sotarokashiuchi/prototype-lesson/docs/picture_hardware/サーボモータ固定.jpg

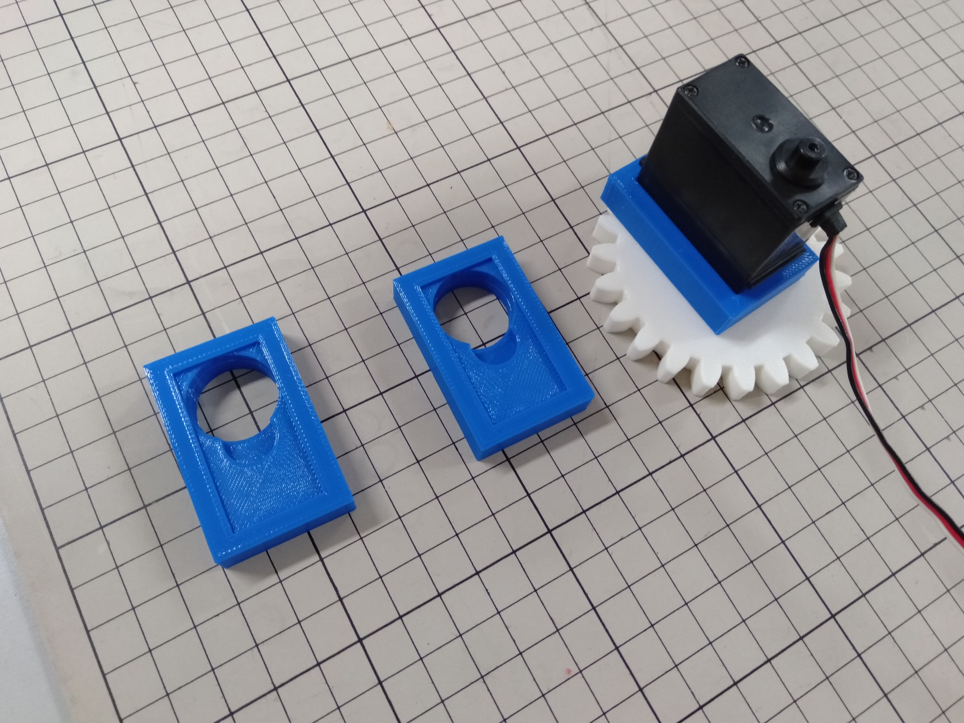
docs/picture_hardware/サーボモータ固定.jpg
