sotarokashiuchi/prototype-lesson/docs/picture_hardware/スクリーンショット 2025-07-04 091845.png

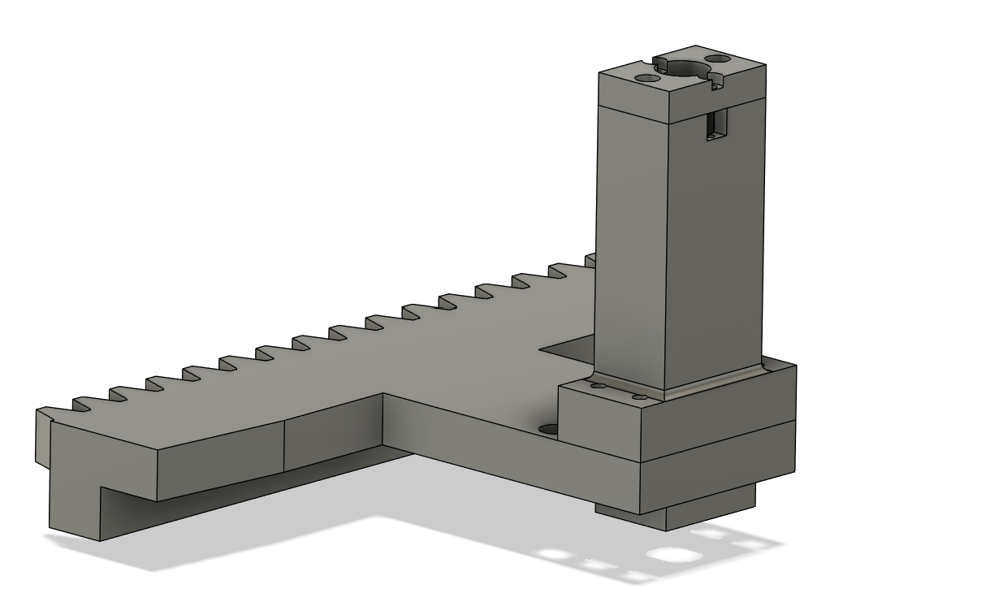
docs/picture_hardware/スクリーンショット 2025-07-04 091845.png
