sotarokashiuchi/prototype-lesson/docs/picture_hardware/スクリーンショット 2025-07-04 120317.png

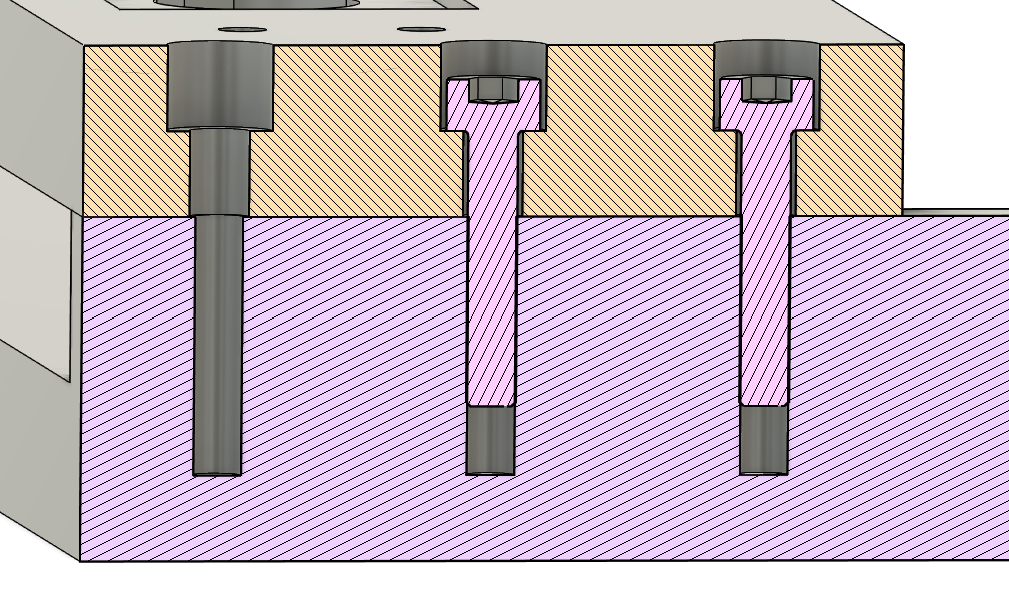
docs/picture_hardware/スクリーンショット 2025-07-04 120317.png
