sotarokashiuchi/prototype-lesson/docs/picture_hardware/スクリーンショット 2025-07-07 123605.png

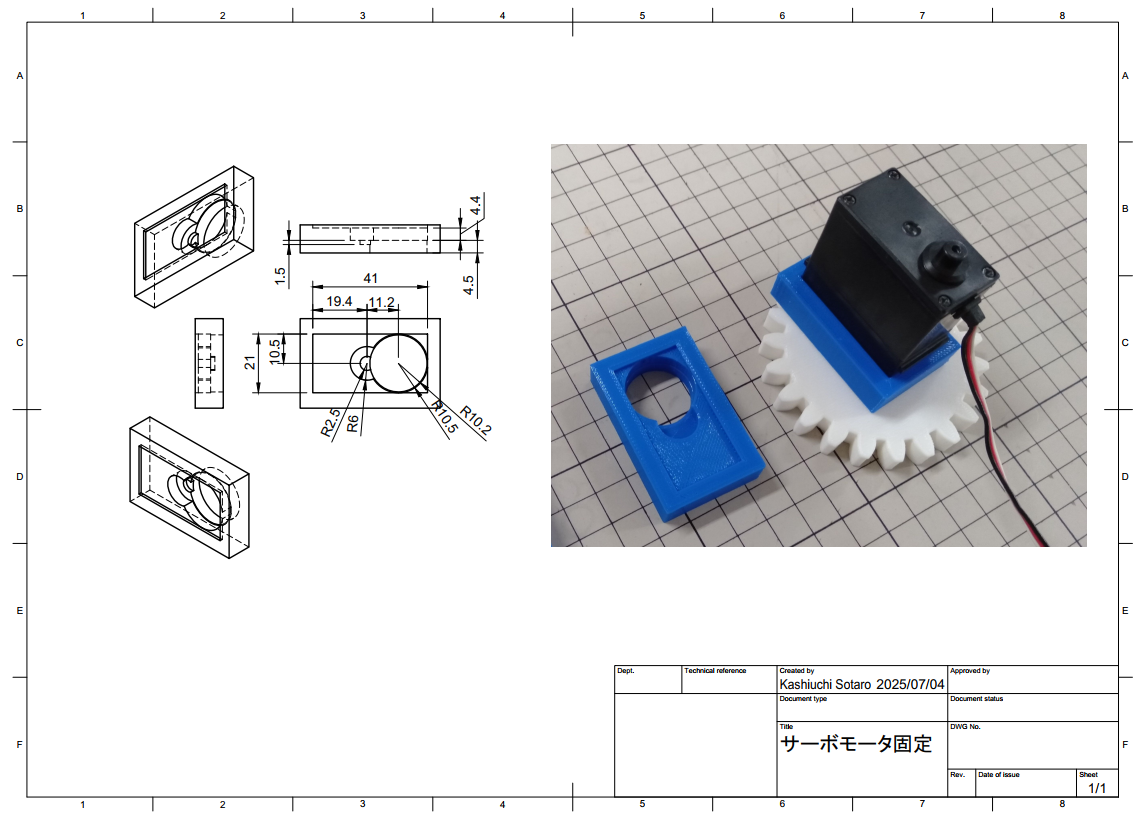
docs/picture_hardware/スクリーンショット 2025-07-07 123605.png
