sotarokashiuchi/prototype-lesson/docs/picture_hardware/スクリーンショット 2025-07-08 163721.png

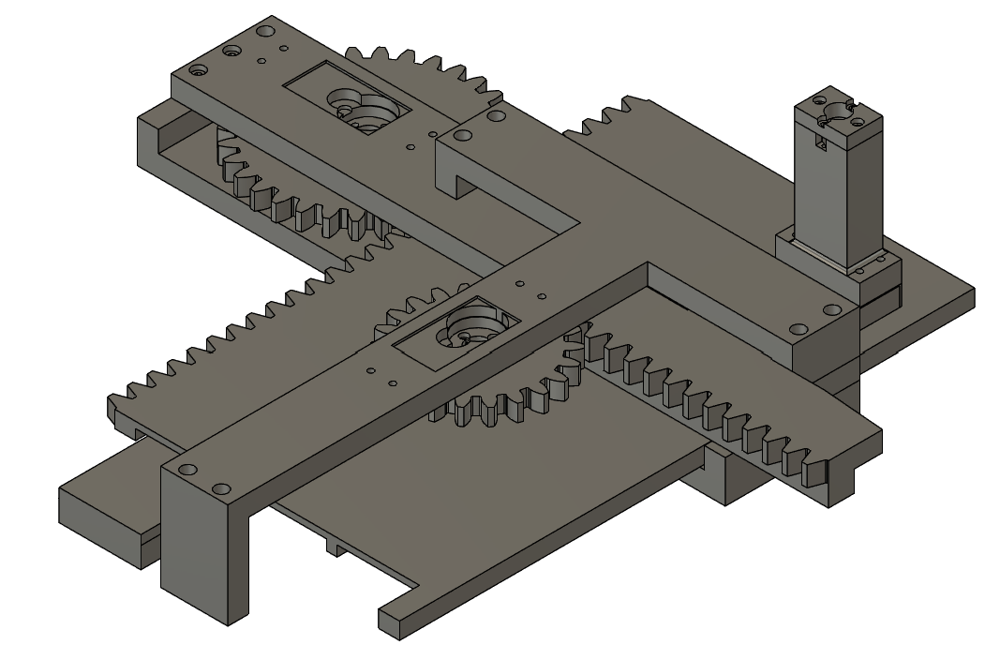
docs/picture_hardware/スクリーンショット 2025-07-08 163721.png
