sotarokashiuchi/prototype-lesson/docs/picture_hardware/スクリーンショット 2025-07-14 133244.png

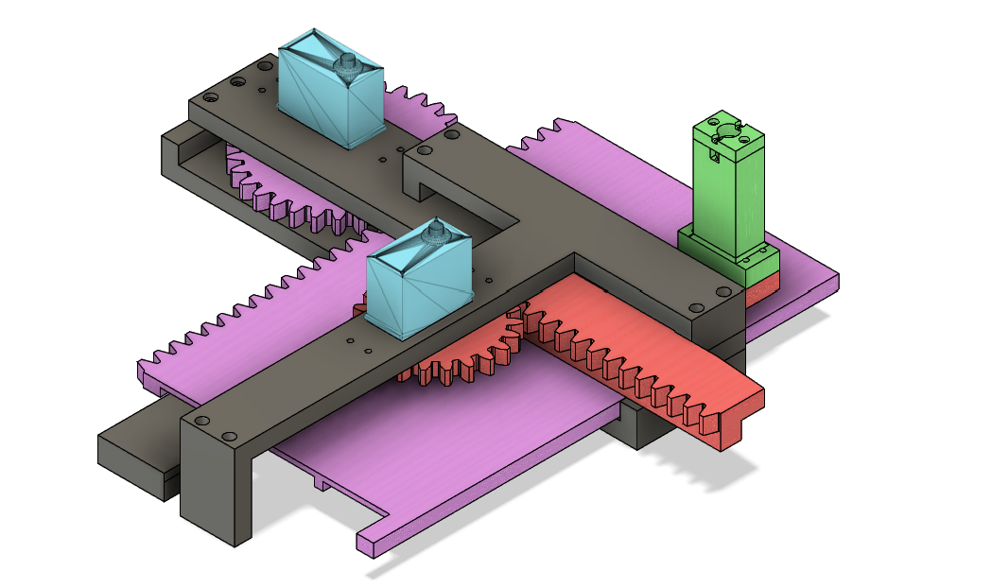
docs/picture_hardware/スクリーンショット 2025-07-14 133244.png
