sotarokashiuchi/prototype-lesson/docs/picture_hardware/ペン取り付け機3.jpg

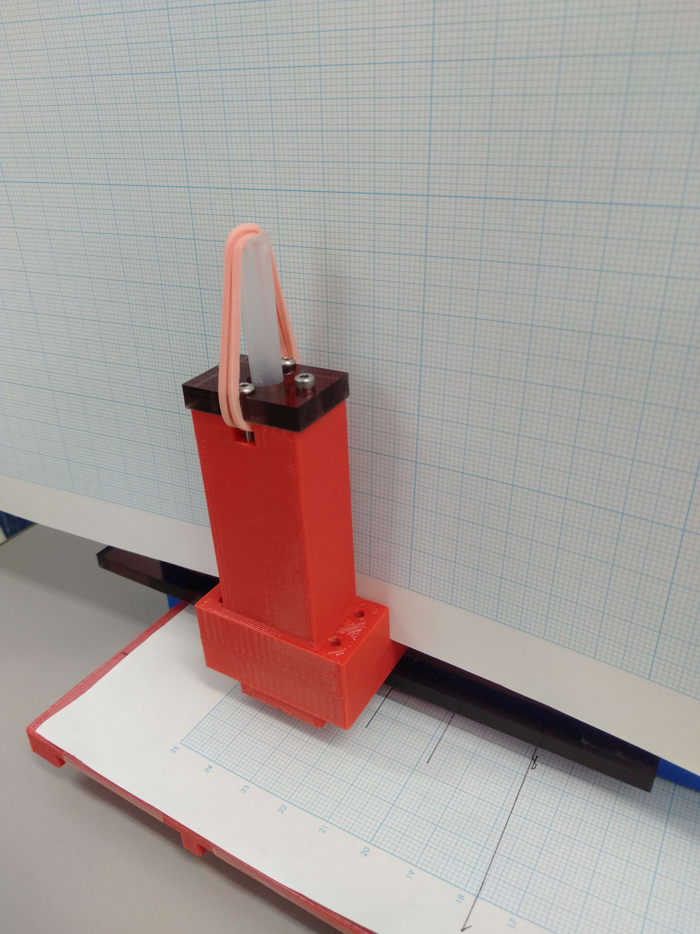
docs/picture_hardware/ペン取り付け機3.jpg
