sotarokashiuchi/prototype-lesson/docs/picture_hardware/ペン取り付け機構2.jpg

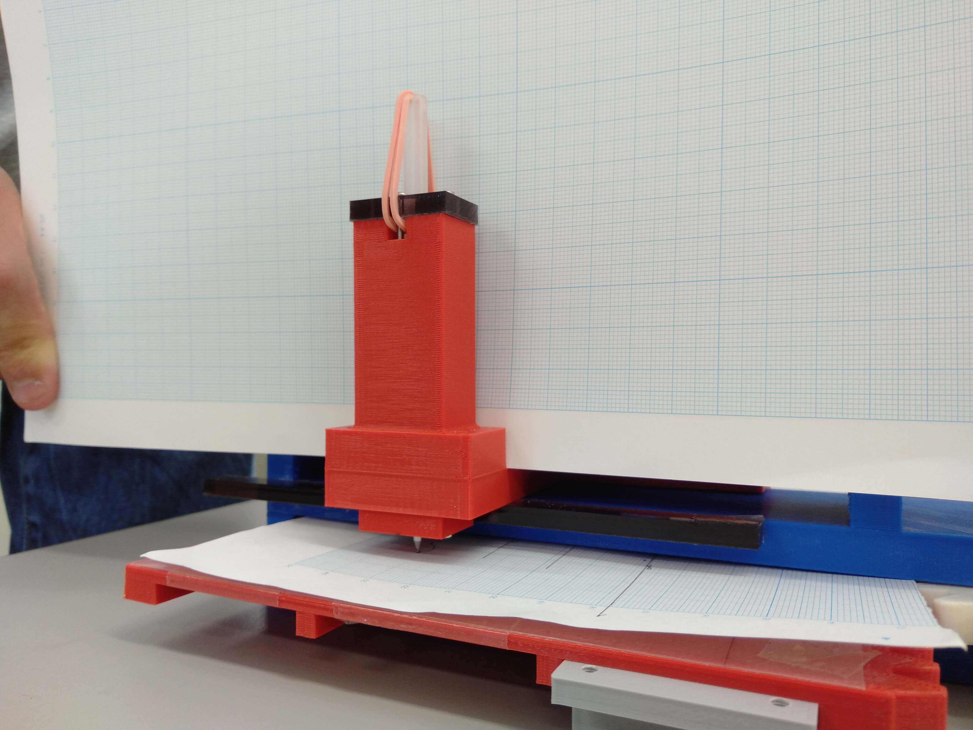
docs/picture_hardware/ペン取り付け機構2.jpg
