sotarokashiuchi/prototype-lesson/docs/picture_hardware/マシン本体1.jpg

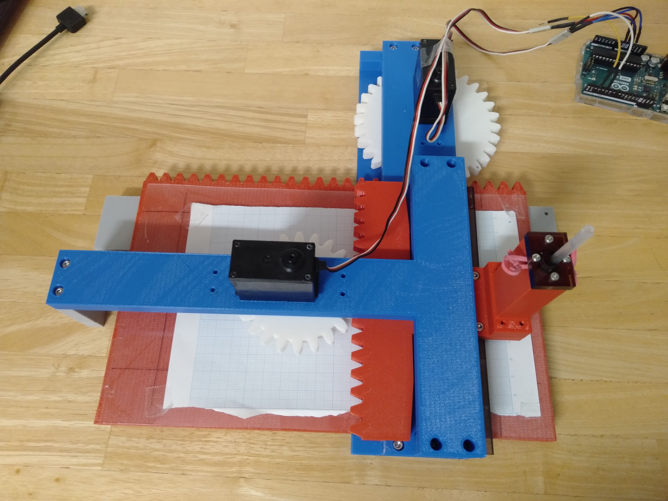
docs/picture_hardware/マシン本体1.jpg
