sotarokashiuchi/prototype-lesson/docs/picture_hardware/マシン本体3.jpg

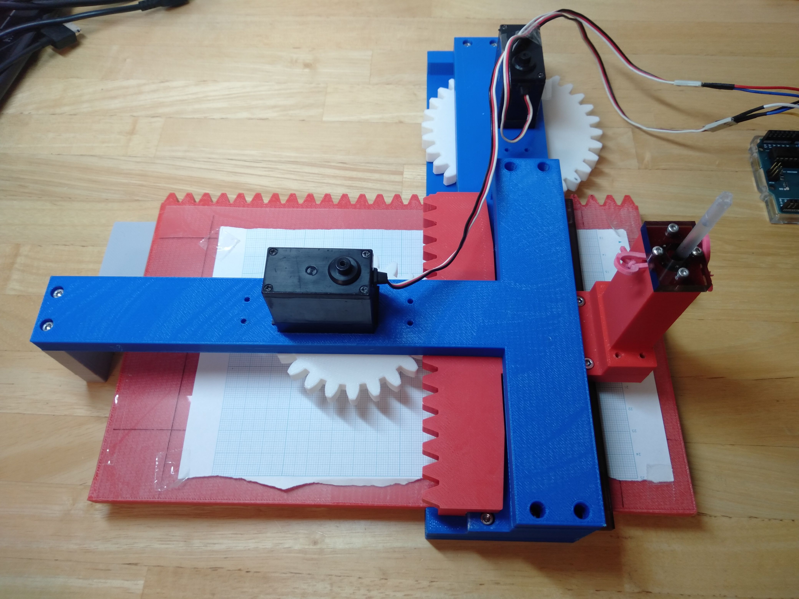
docs/picture_hardware/マシン本体3.jpg
