sotarokashiuchi/prototype-lesson/docs/picture_hardware/モータ精度測定1.jpg

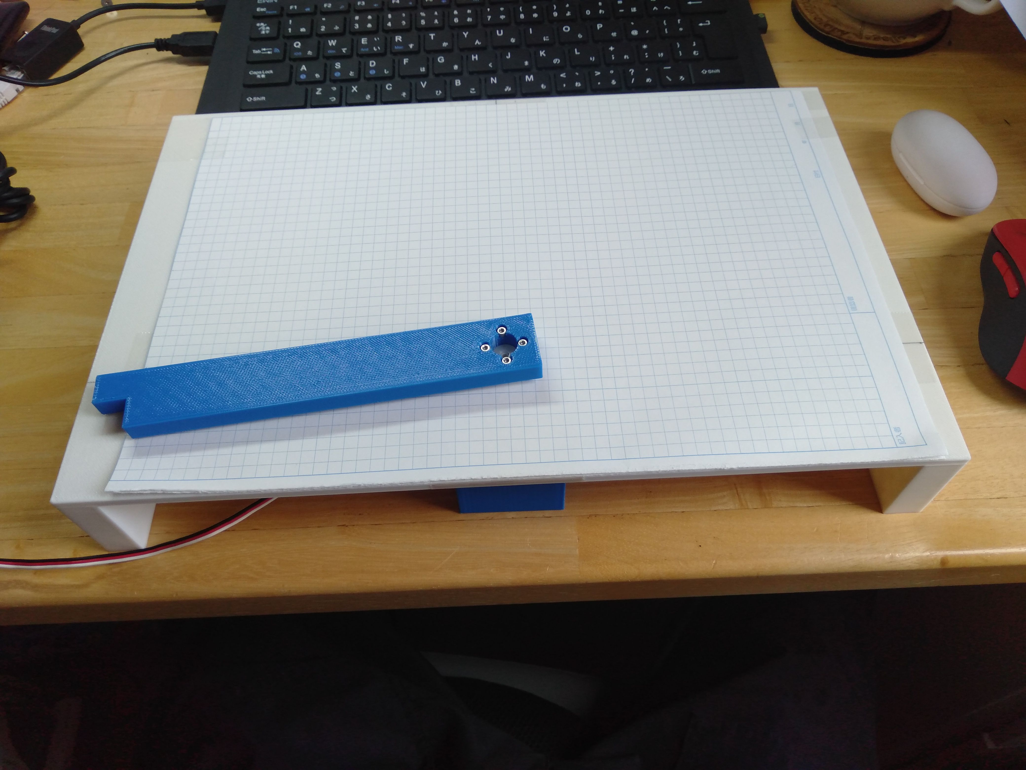
docs/picture_hardware/モータ精度測定1.jpg
