sotarokashiuchi/prototype-lesson/docs/picture_hardware/モータ精度測定2.jpg

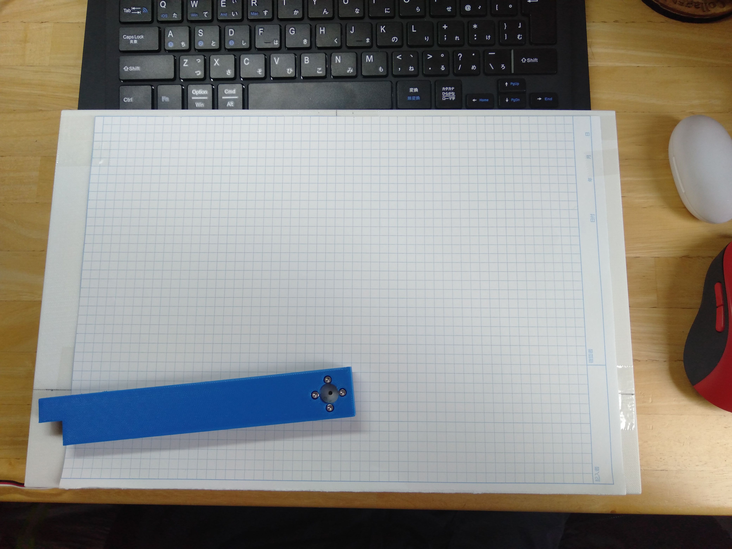
docs/picture_hardware/モータ精度測定2.jpg
