sotarokashiuchi/prototype-lesson/docs/picture_hardware/機構の選定1.png

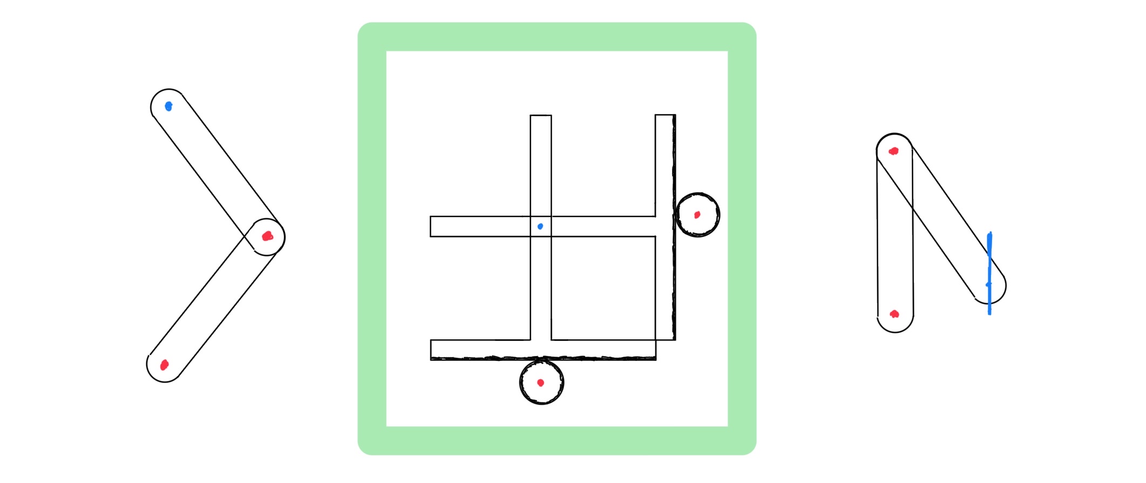
docs/picture_hardware/機構の選定1.png
