sotarokashiuchi/prototype-lesson/docs/picture_software/スクリーンショット 2025-05-23 215608.png

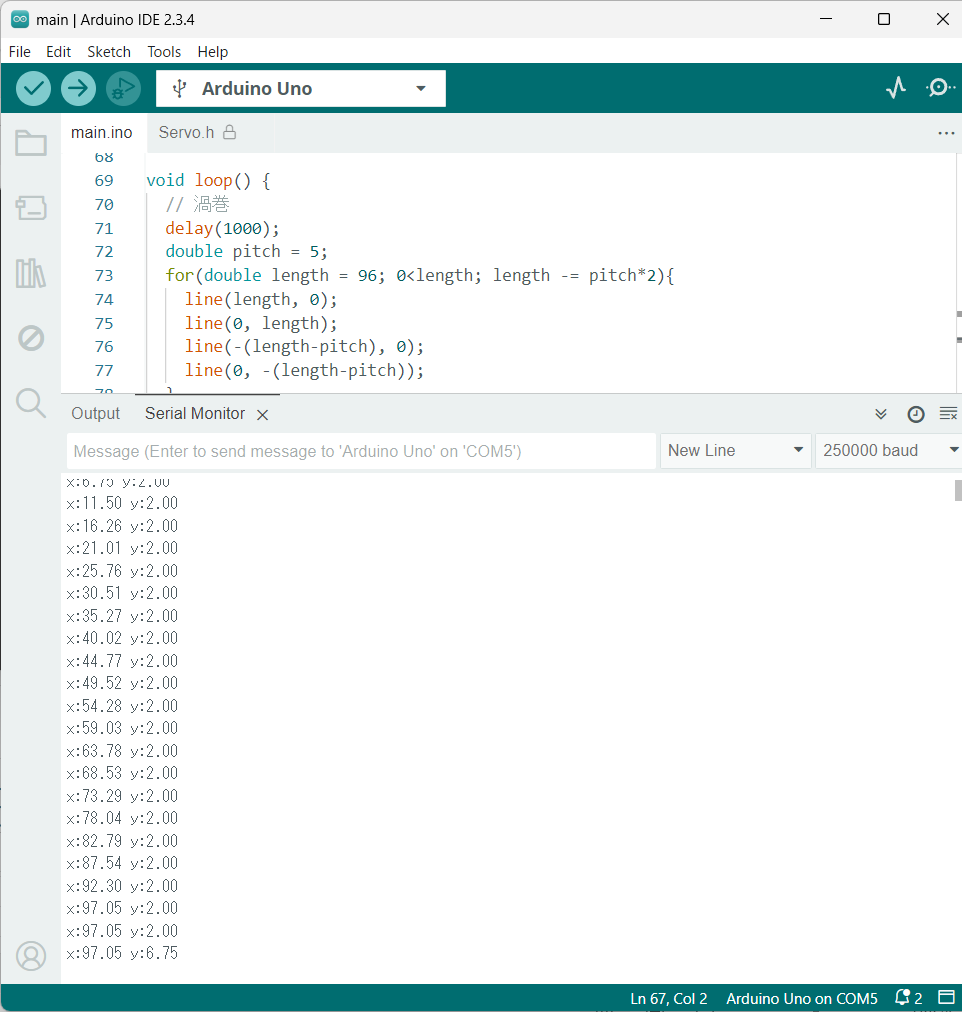
docs/picture_software/スクリーンショット 2025-05-23 215608.png
