sotarokashiuchi/prototype-lesson/docs/picture_software/スクリーンショット 2025-07-01 165109.png

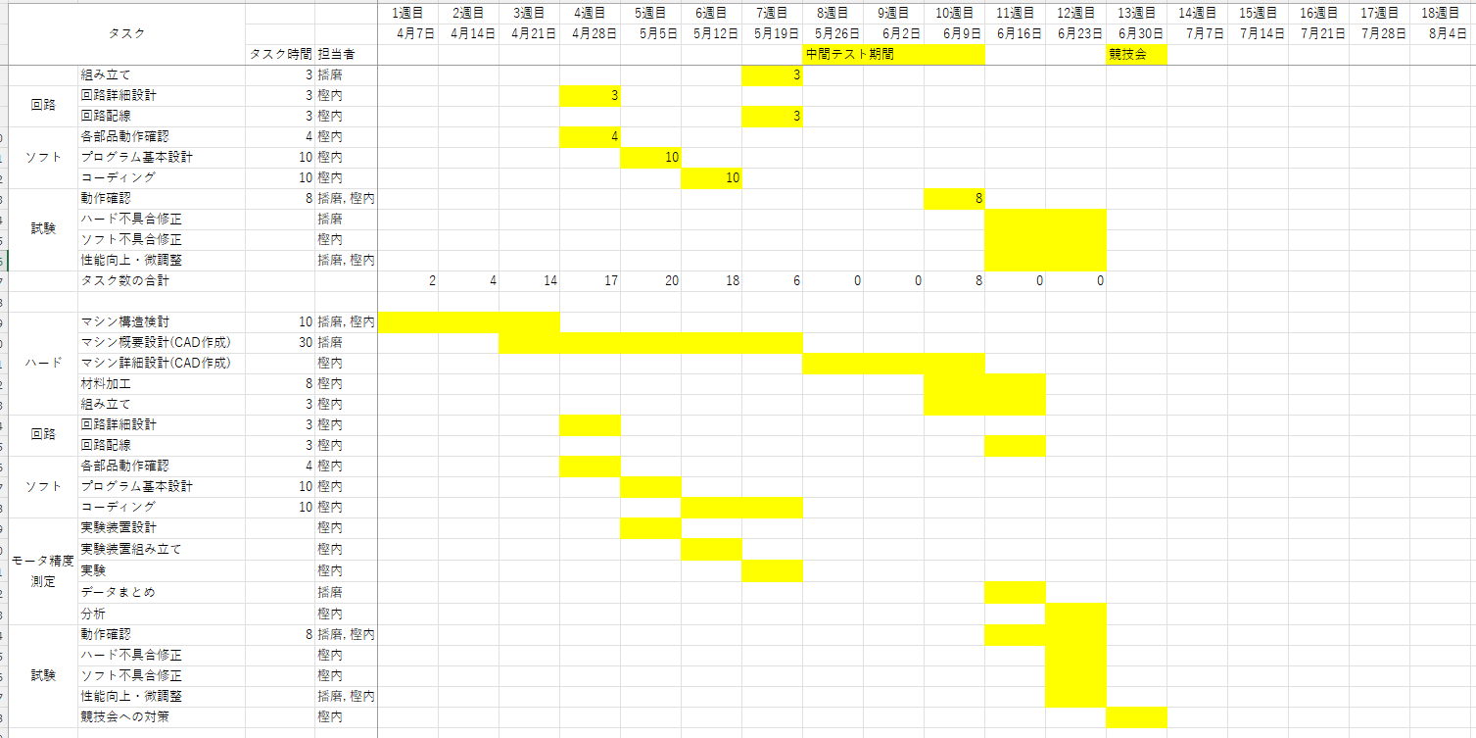
docs/picture_software/スクリーンショット 2025-07-01 165109.png
