sotarokashiuchi/prototype-lesson/docs/picture_software/プロンプト.png

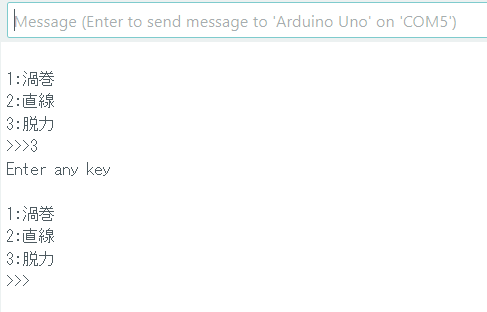
docs/picture_software/プロンプト.png
