sotarokashiuchi/prototype-lesson/docs/record/IMG_20250630_0001.jpg

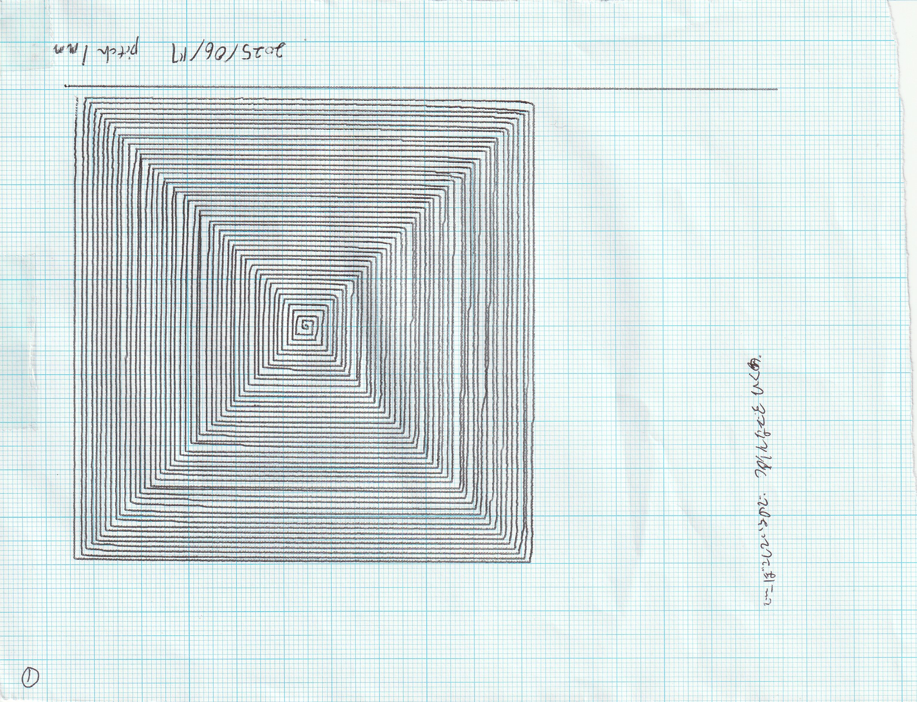
docs/record/IMG_20250630_0001.jpg
