sotarokashiuchi/prototype-lesson/docs/record/IMG_20250630_0002.jpg

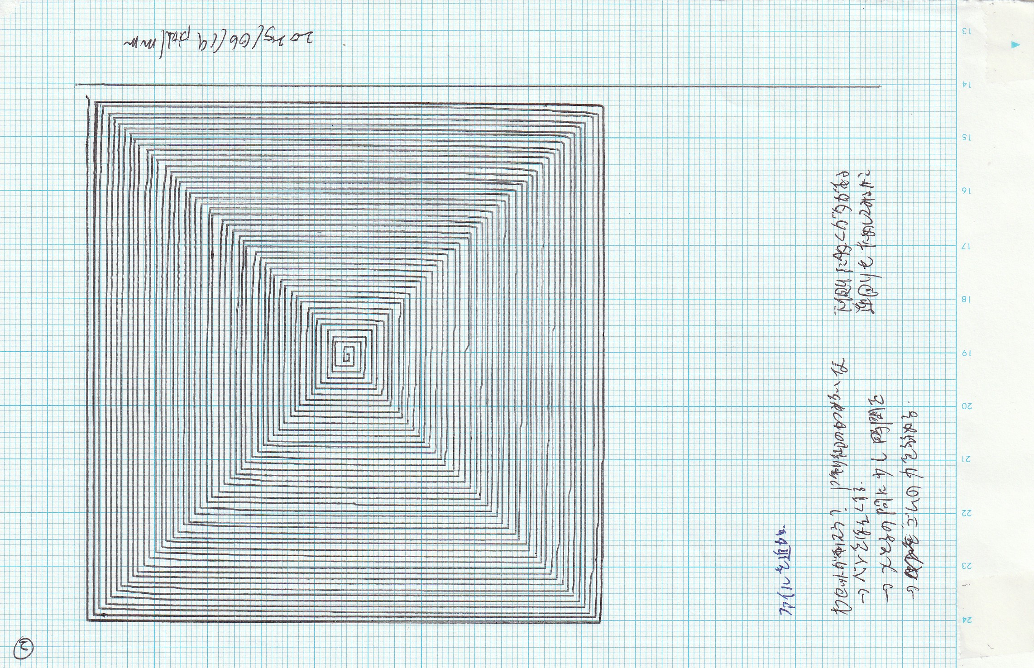
docs/record/IMG_20250630_0002.jpg
