sotarokashiuchi/prototype-lesson/docs/record/IMG_20250630_0003.jpg

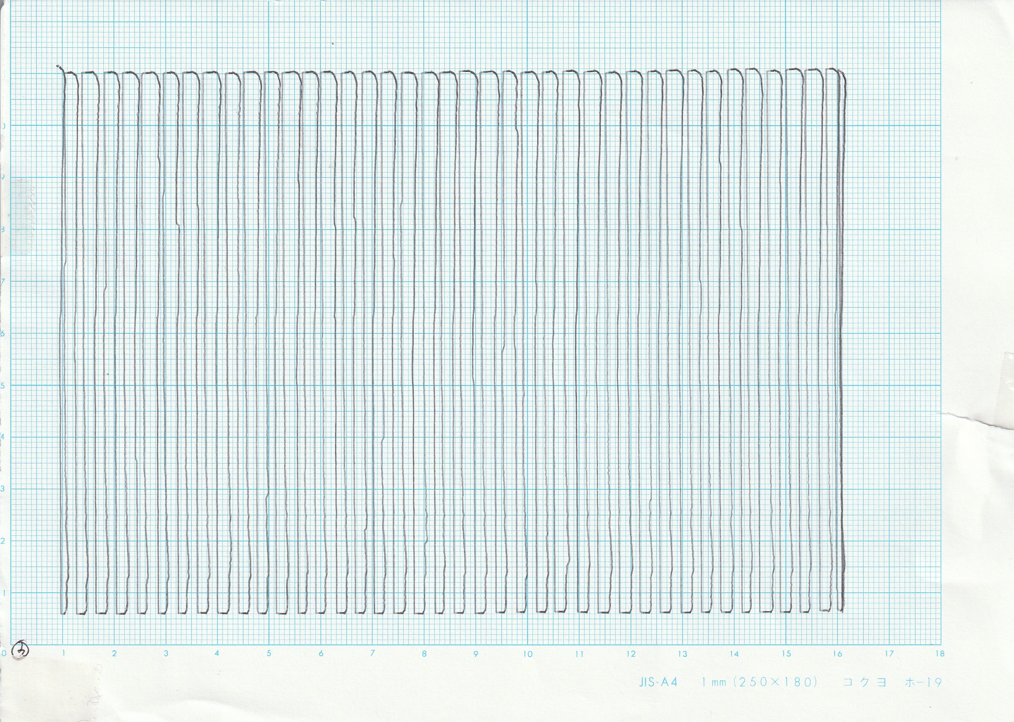
docs/record/IMG_20250630_0003.jpg
