sotarokashiuchi/prototype-lesson/docs/record/IMG_20250630_0004 コピー.jpg

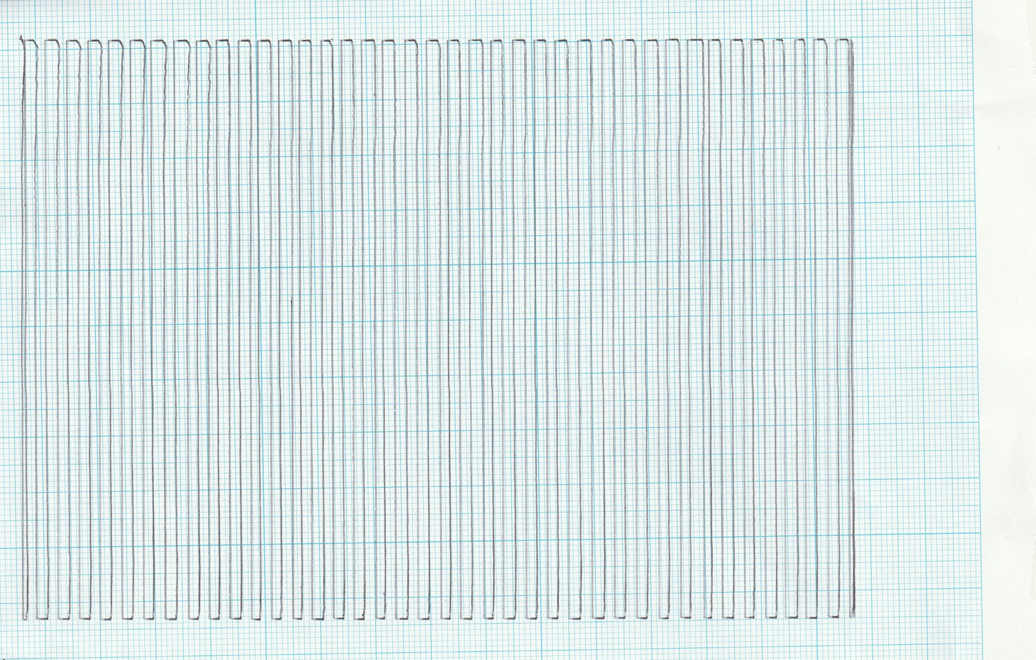
docs/record/IMG_20250630_0004 コピー.jpg
