sotarokashiuchi/prototype-lesson/docs/record/IMG_20250630_0005.jpg

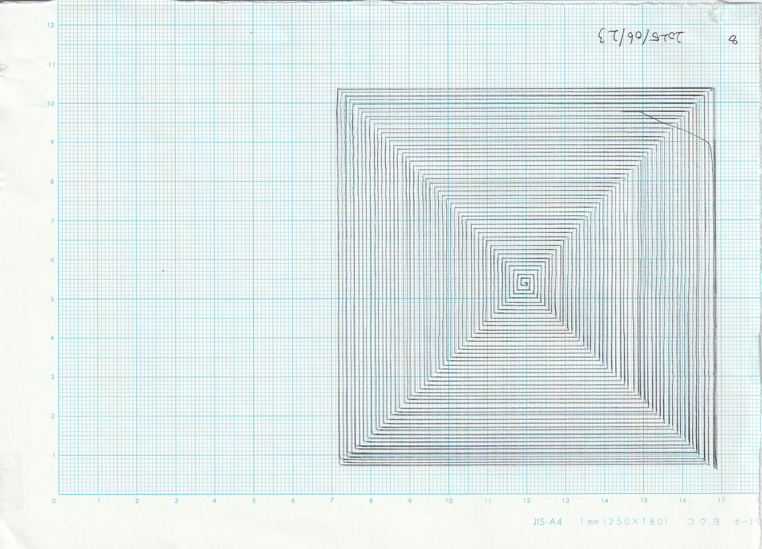
docs/record/IMG_20250630_0005.jpg
