sotarokashiuchi/prototype-lesson/docs/record/IMG_20250630_0006.jpg

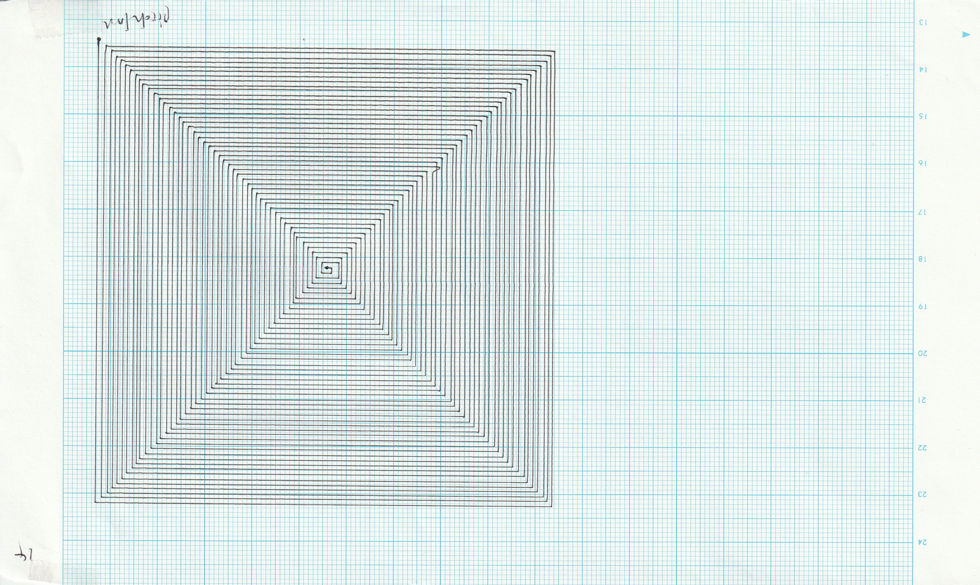
docs/record/IMG_20250630_0006.jpg
