sotarokashiuchi/prototype-lesson/docs/record/IMG_20250630_0007.jpg

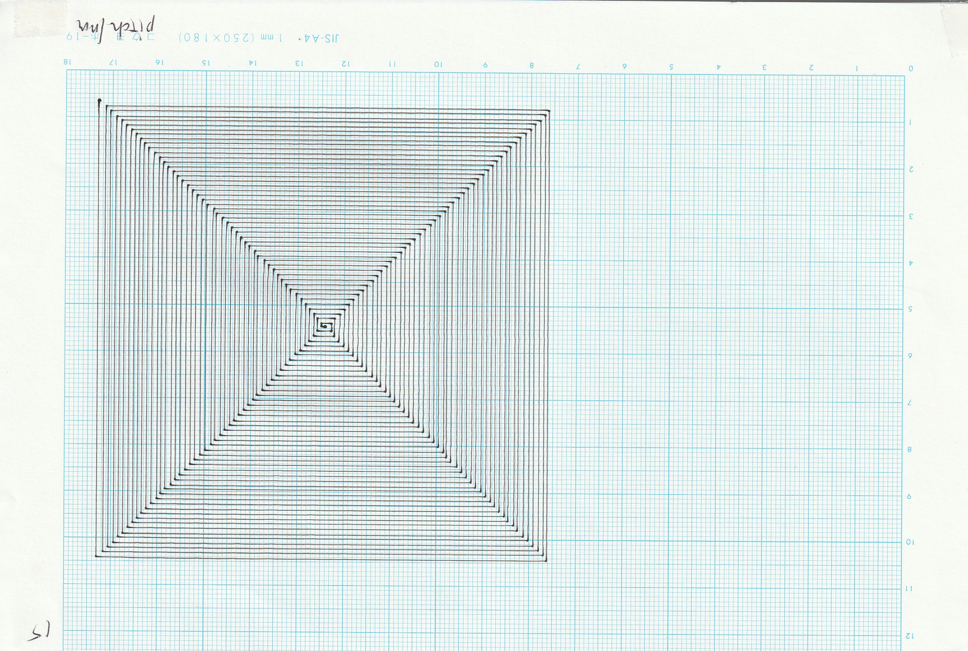
docs/record/IMG_20250630_0007.jpg
