sotarokashiuchi/prototype-lesson/docs/record/IMG_20250630_0008.jpg

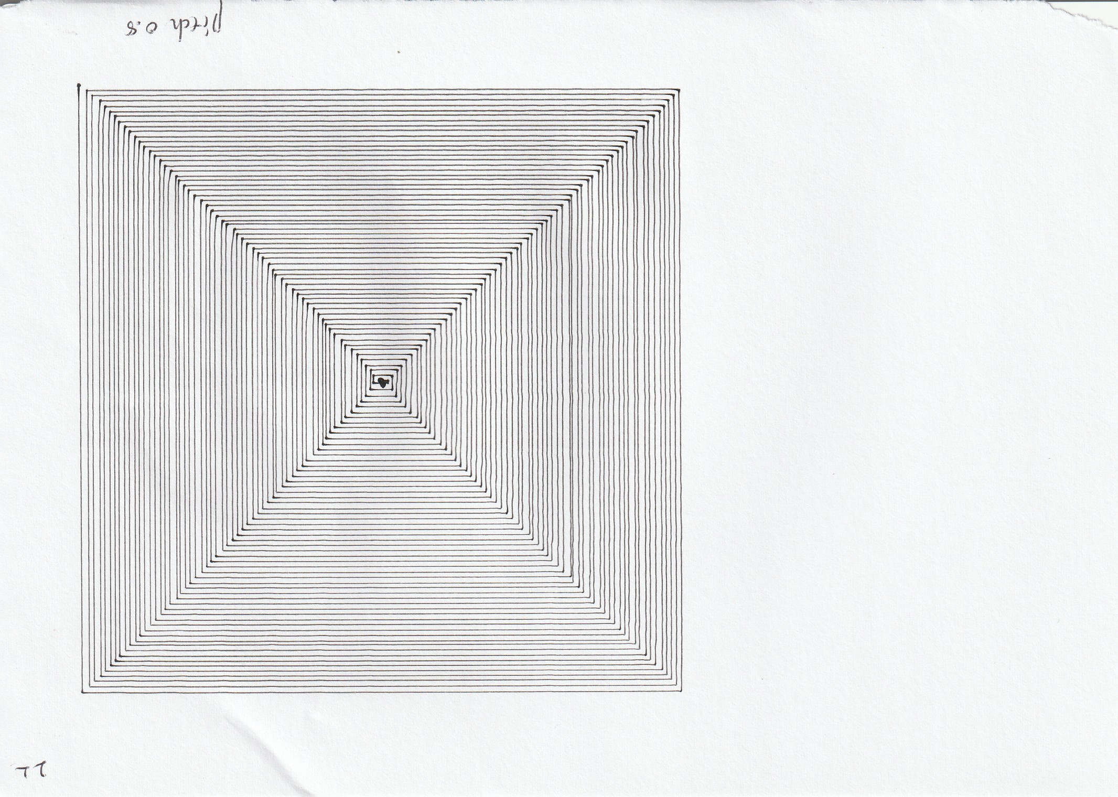
docs/record/IMG_20250630_0008.jpg
