sotarokashiuchi/prototype-lesson/docs/record/IMG_20250630_0009.jpg

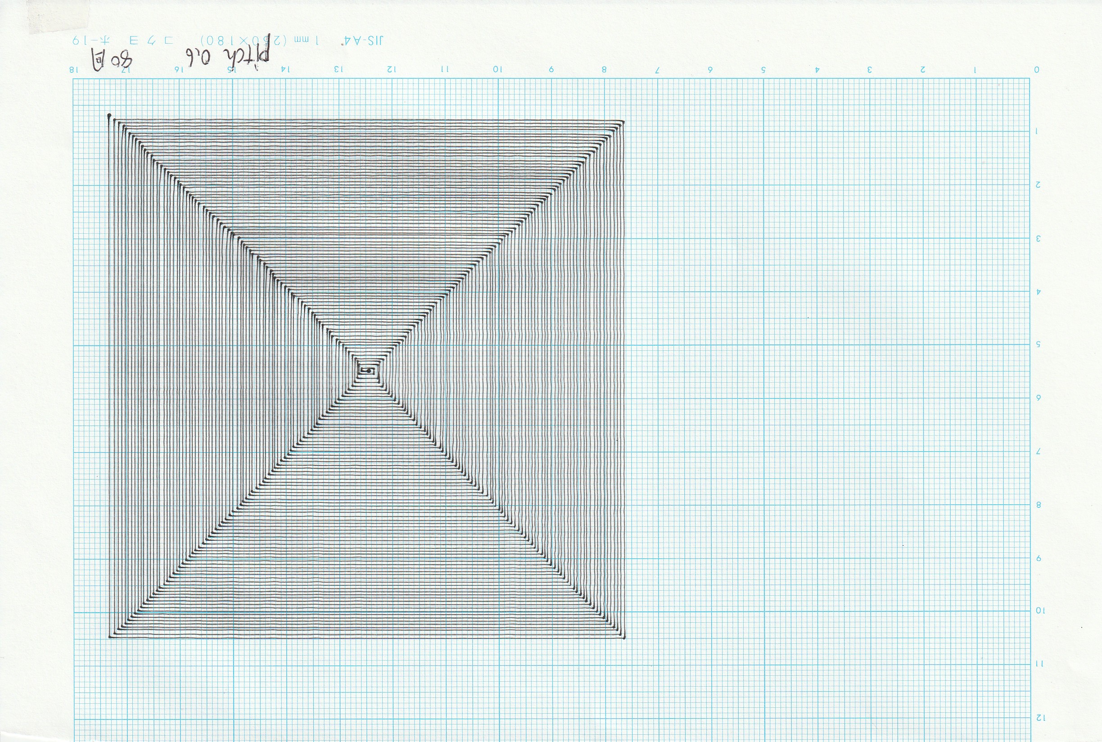
docs/record/IMG_20250630_0009.jpg
