sotarokashiuchi/prototype-lesson/docs/record/IMG_20250630_0010.jpg

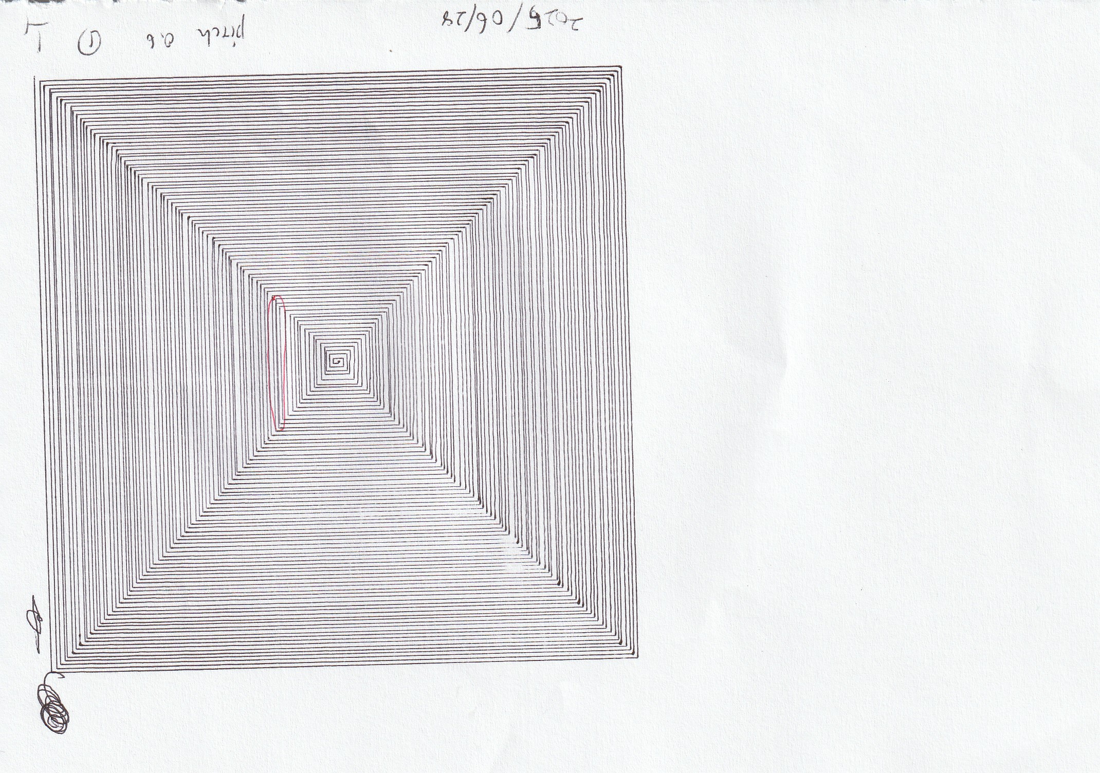
docs/record/IMG_20250630_0010.jpg
