sotarokashiuchi/prototype-lesson/docs/record/IMG_20250630_0012.jpg

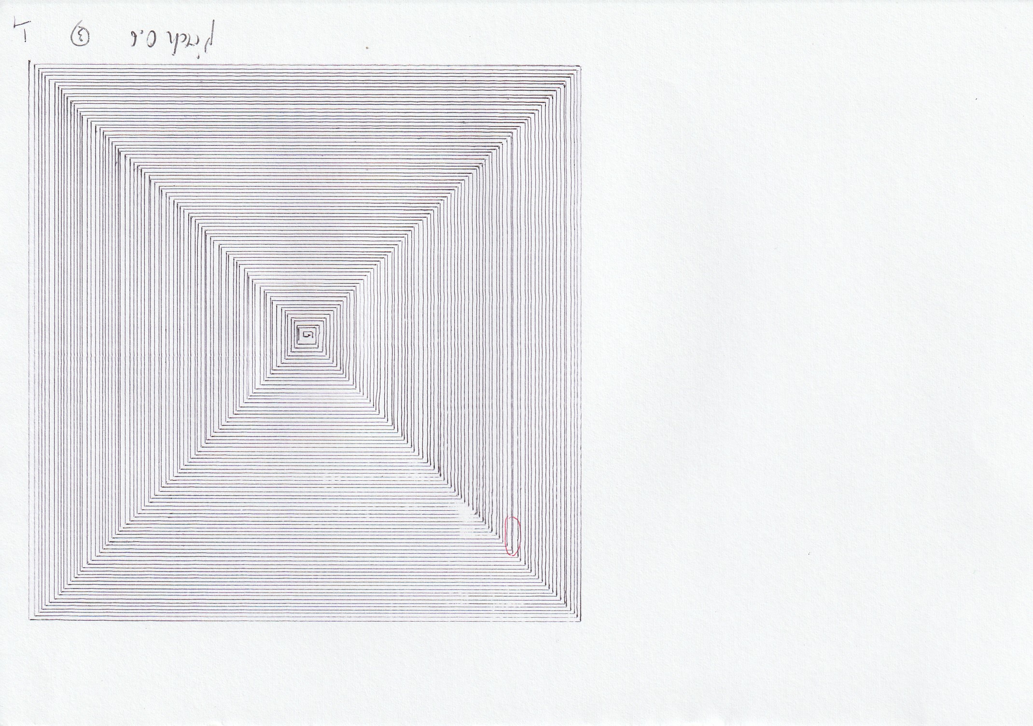
docs/record/IMG_20250630_0012.jpg
