sotarokashiuchi/prototype-lesson/docs/record/IMG_20250630_0013.jpg

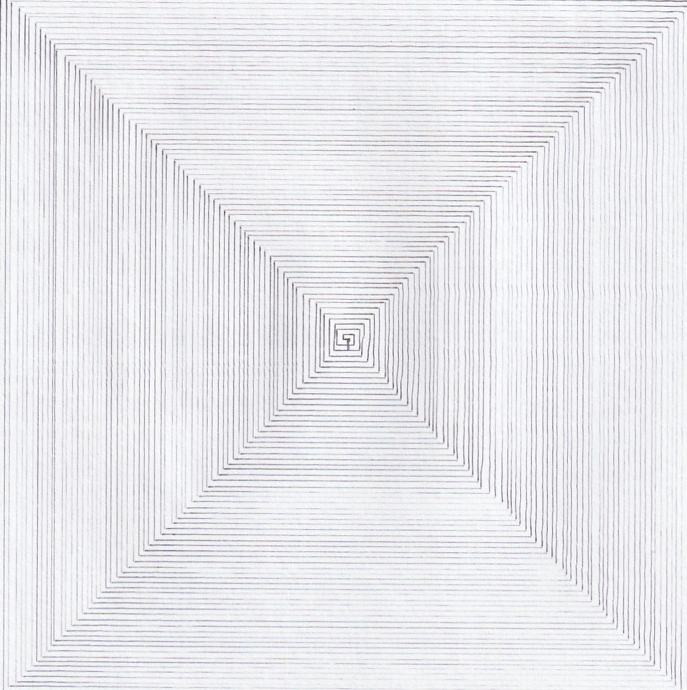
docs/record/IMG_20250630_0013.jpg
