sotarokashiuchi/prototype-lesson/docs/record/IMG_20250630_0014.jpg

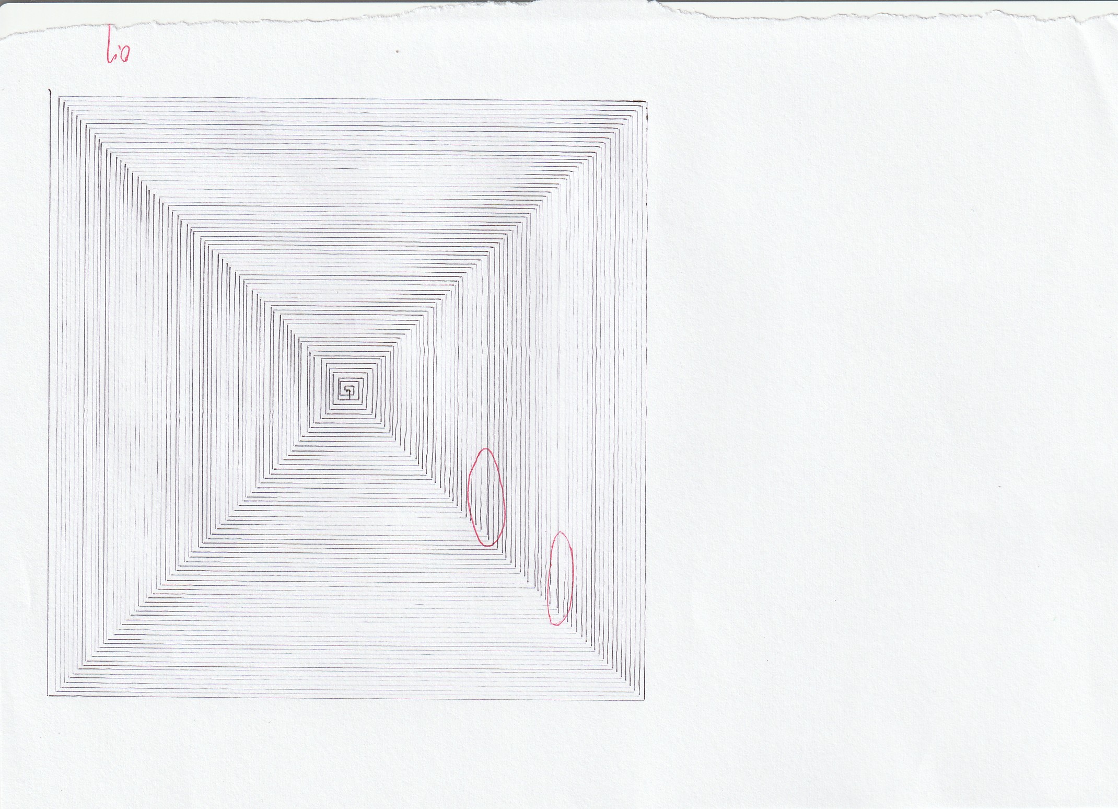
docs/record/IMG_20250630_0014.jpg
