sotarokashiuchi/prototype-lesson/docs/record/IMG_20250630_0015.jpg

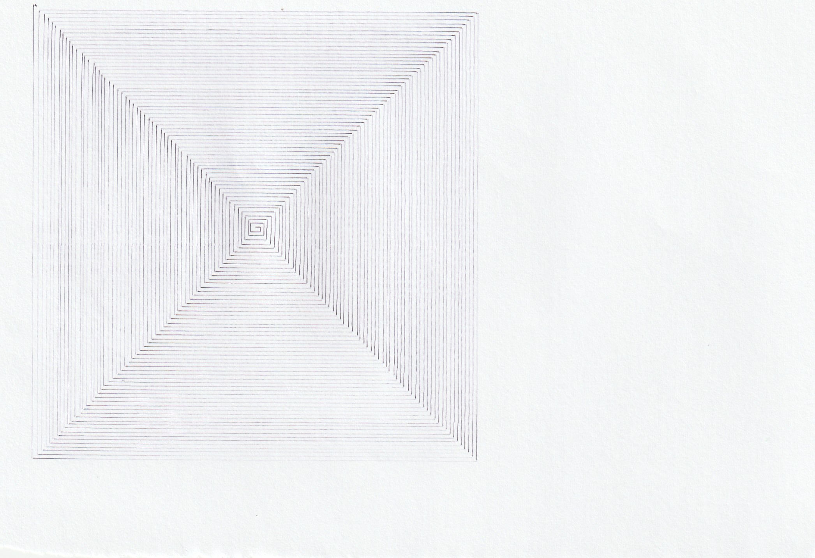
docs/record/IMG_20250630_0015.jpg
