sotarokashiuchi/prototype-lesson/docs/record/最高記録_渦巻(pitch0.6).jpg

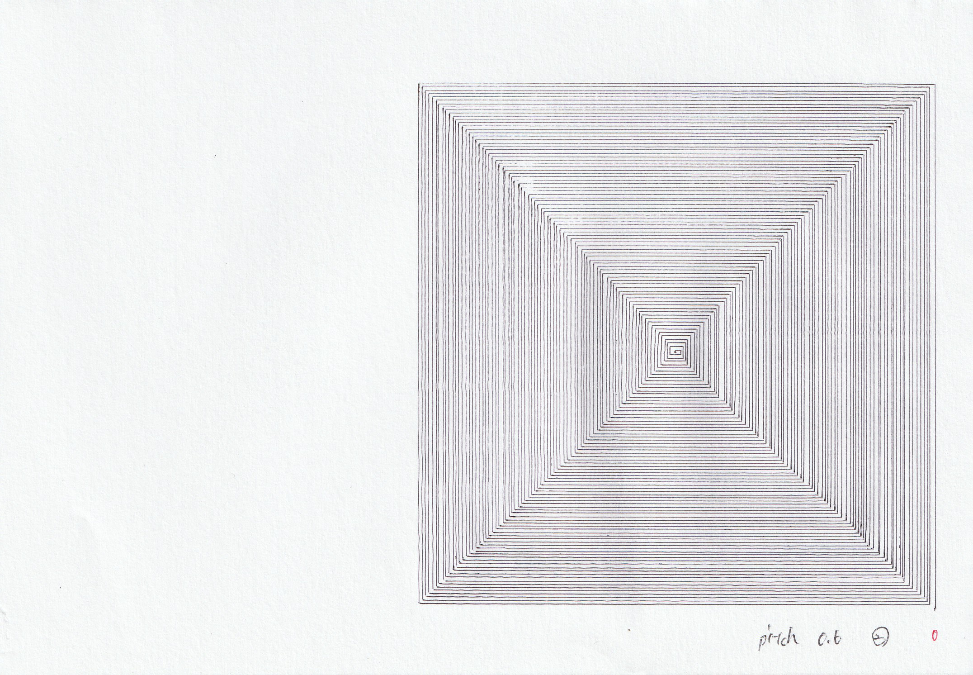
docs/record/最高記録_渦巻(pitch0.6).jpg
