sotarokashiuchi/prototype-lesson/docs/record/最高記録_直線.jpg

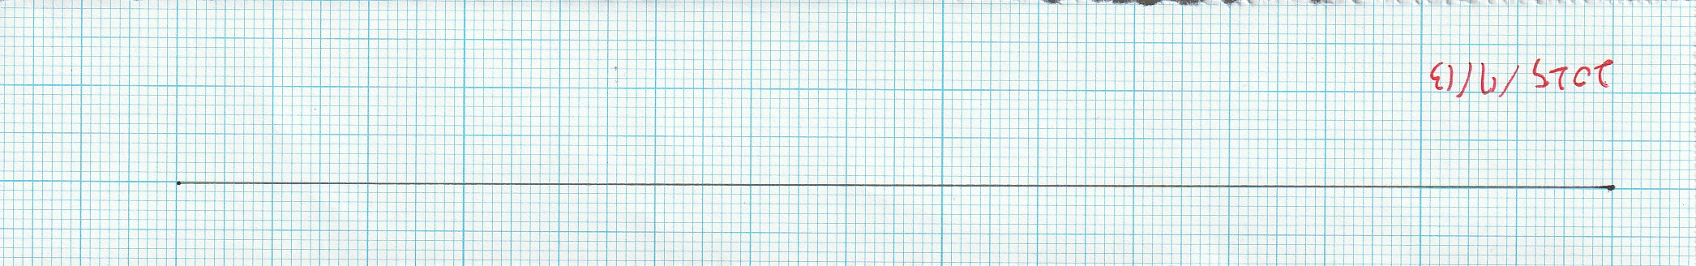
docs/record/最高記録_直線.jpg
