sotarokashiuchi/prototype-lesson/docs/picture_hardware/モータ固定 v2.pdf

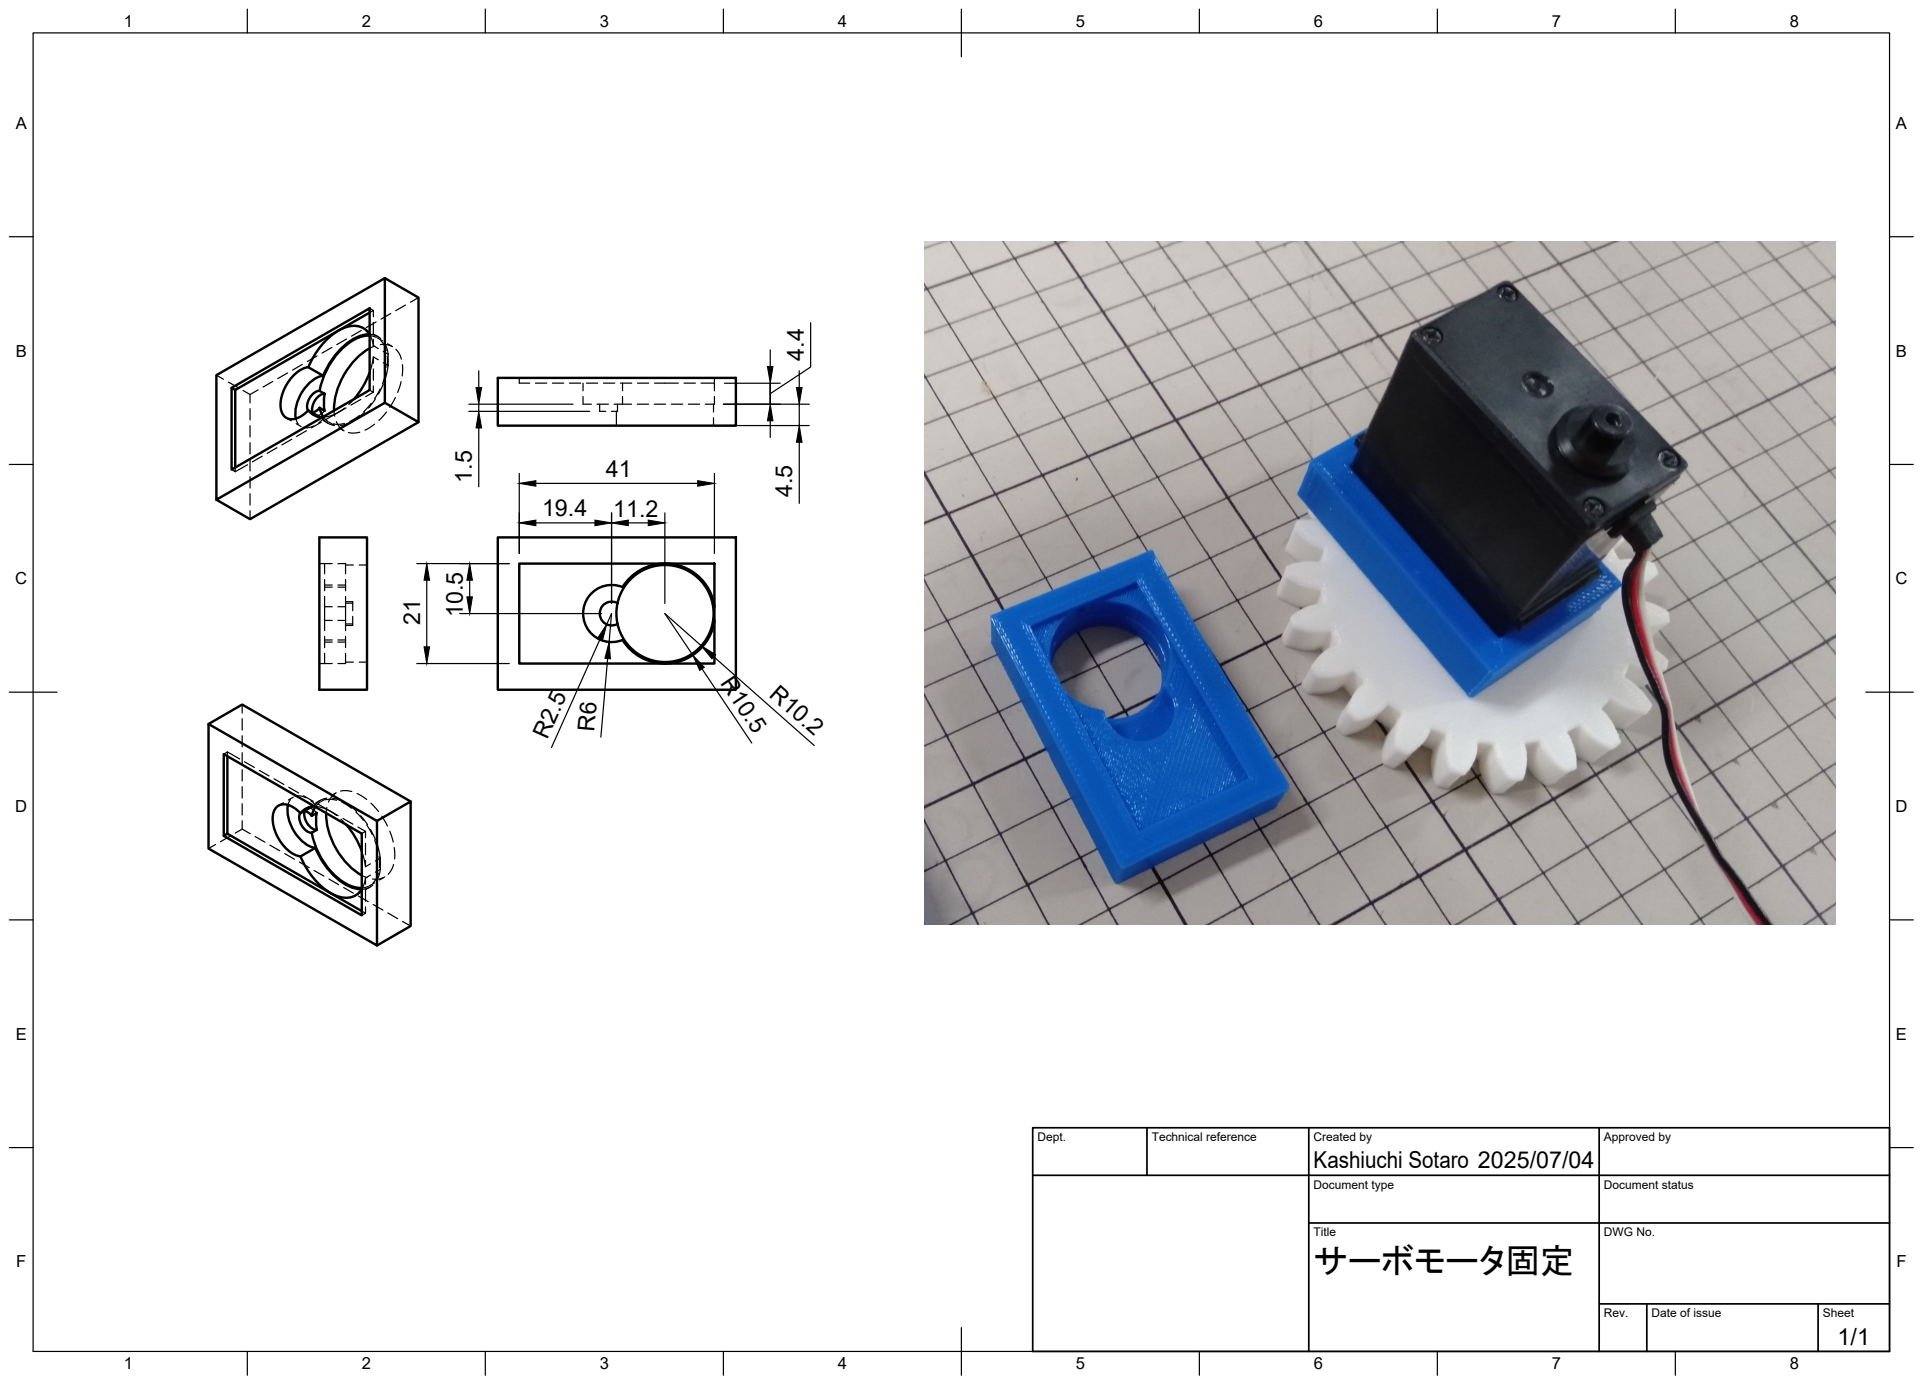
[picture p64: page 1]
Title; DWG No.; Rev.; Date of issue; Sheet

Dept. | Technical reference | Created by Kashiuchi Sotaro 2025/07/04 | Approved by

Document type | Document status
